OldBuzz/Speedometer-Corrector-Arduino-based/Photos/Cable_01.jpg

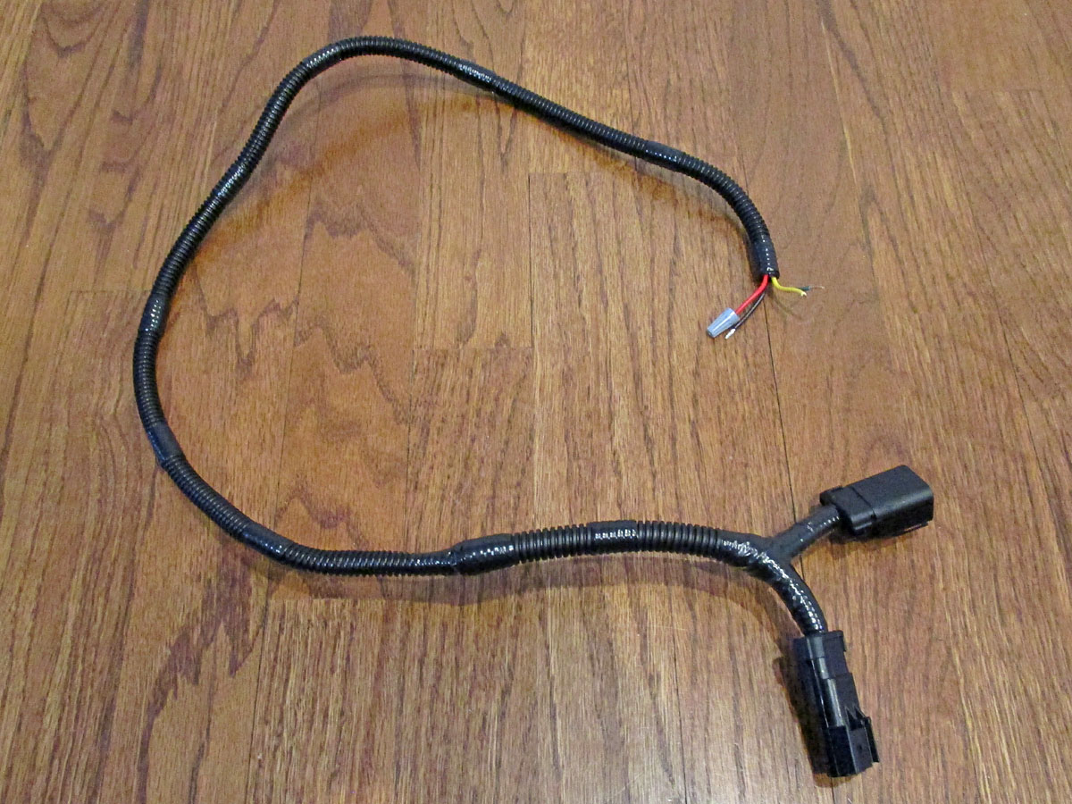
Photos/Cable_01.jpg
