OldBuzz/Speedometer-Corrector-Arduino-based/Photos/Board_02.jpg

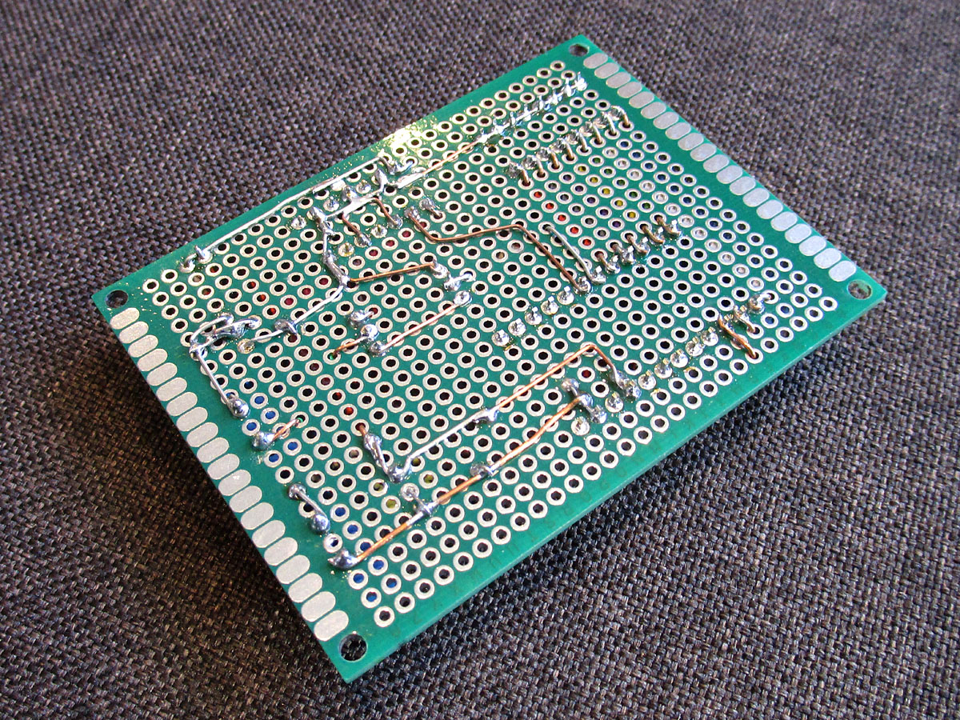
Photos/Board_02.jpg
