OldBuzz/Speedometer-Corrector-Arduino-based/Jeep/Speedo_Corrector_Cable.gif

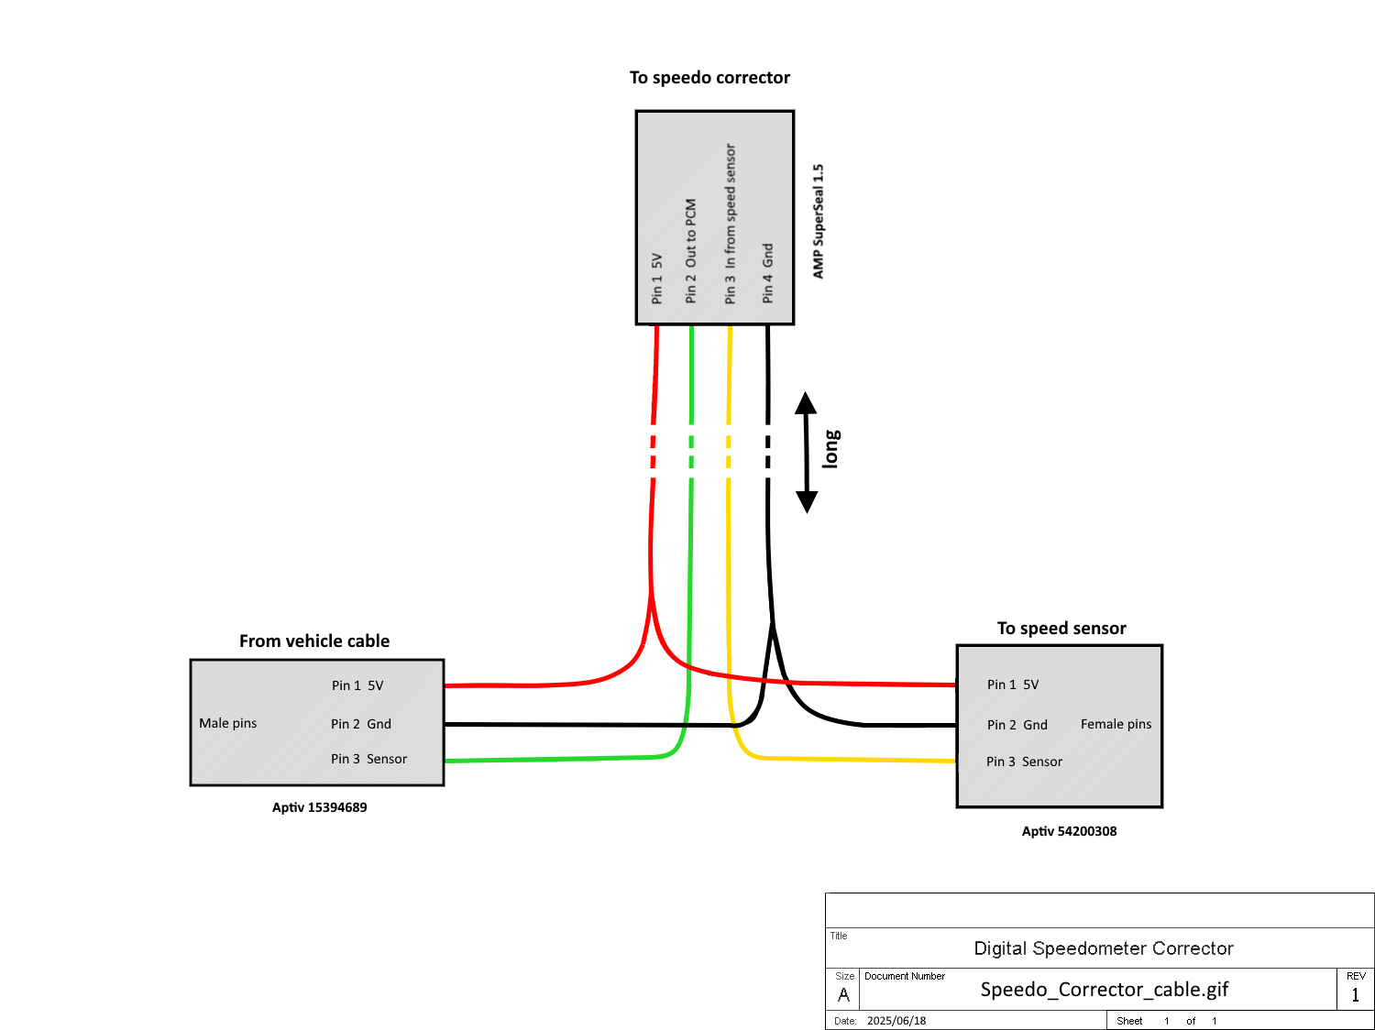
Jeep/Speedo_Corrector_Cable.gif
