OldBuzz/Speedometer-Corrector-Arduino-based/Jeep/Speedo_Sensor_Wires.gif

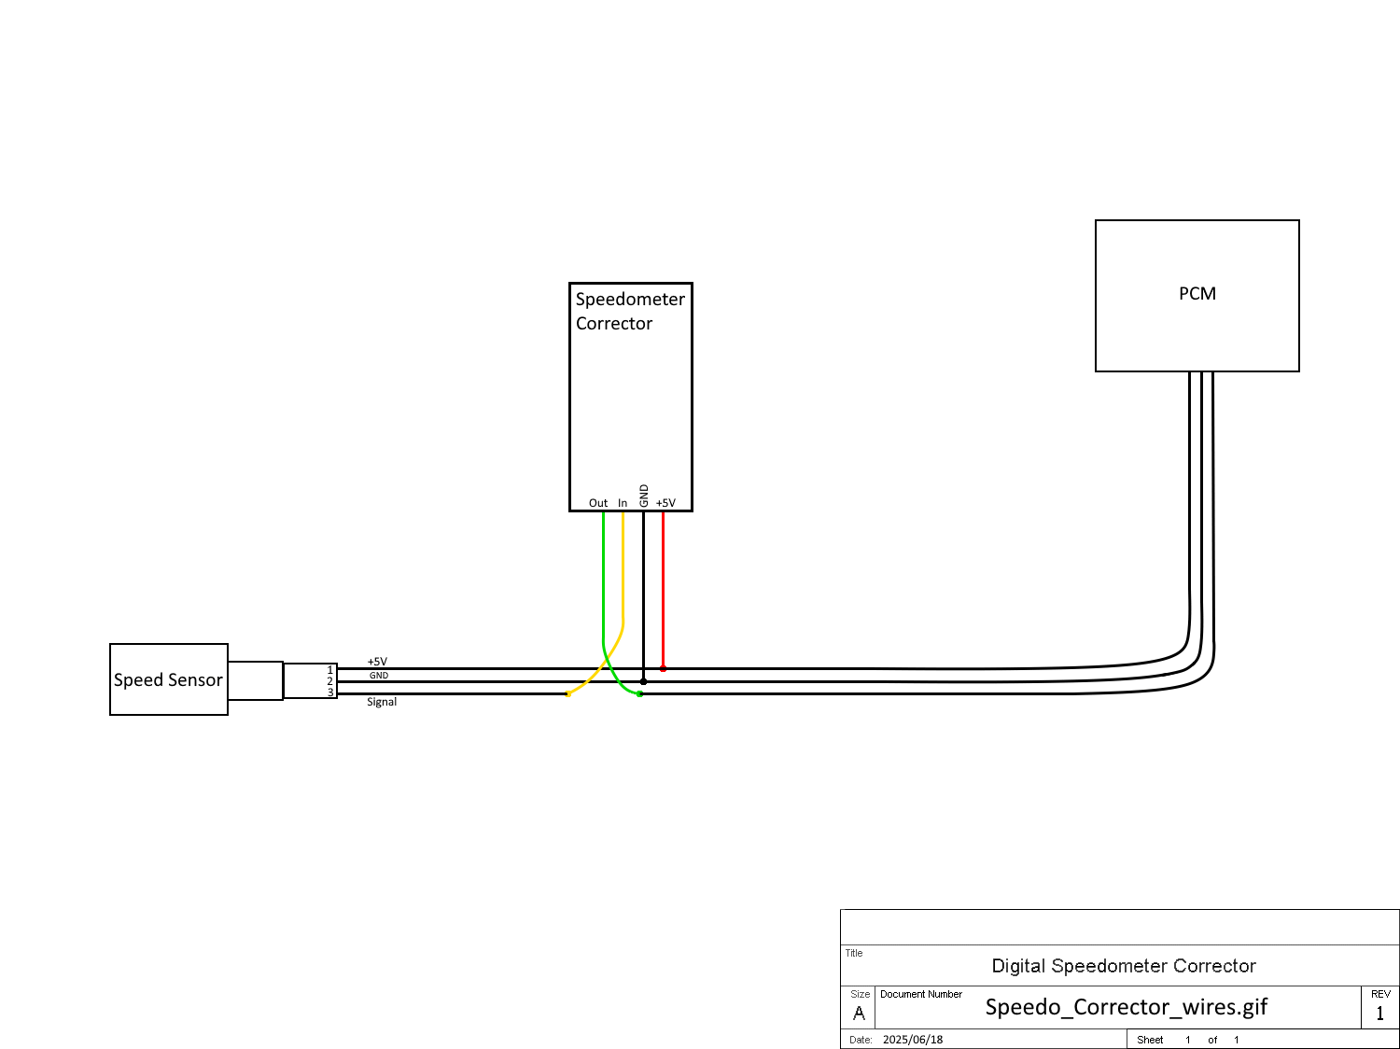
Jeep/Speedo_Sensor_Wires.gif
