OldBuzz/Speedometer-Corrector-Arduino-based/Photos/Board_01.jpg

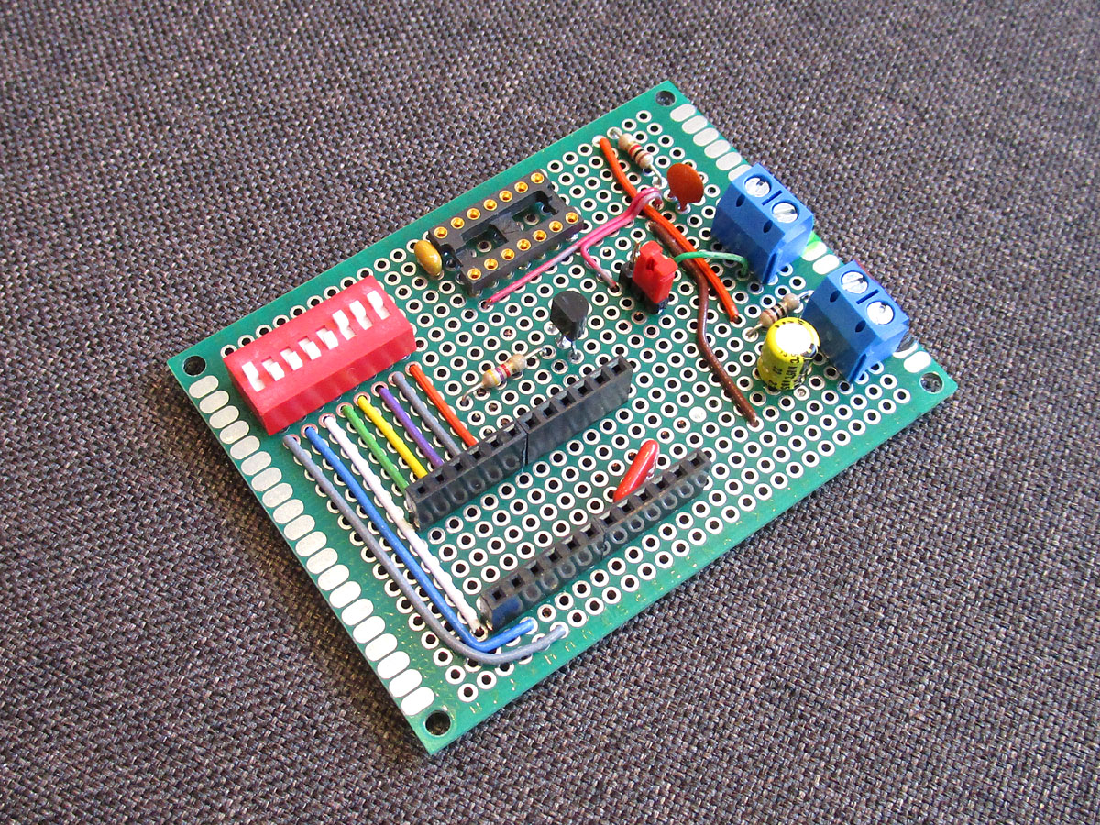
Photos/Board_01.jpg
