OldBuzz/Speedometer-Corrector-Arduino-based/Photos/Board_03.jpg

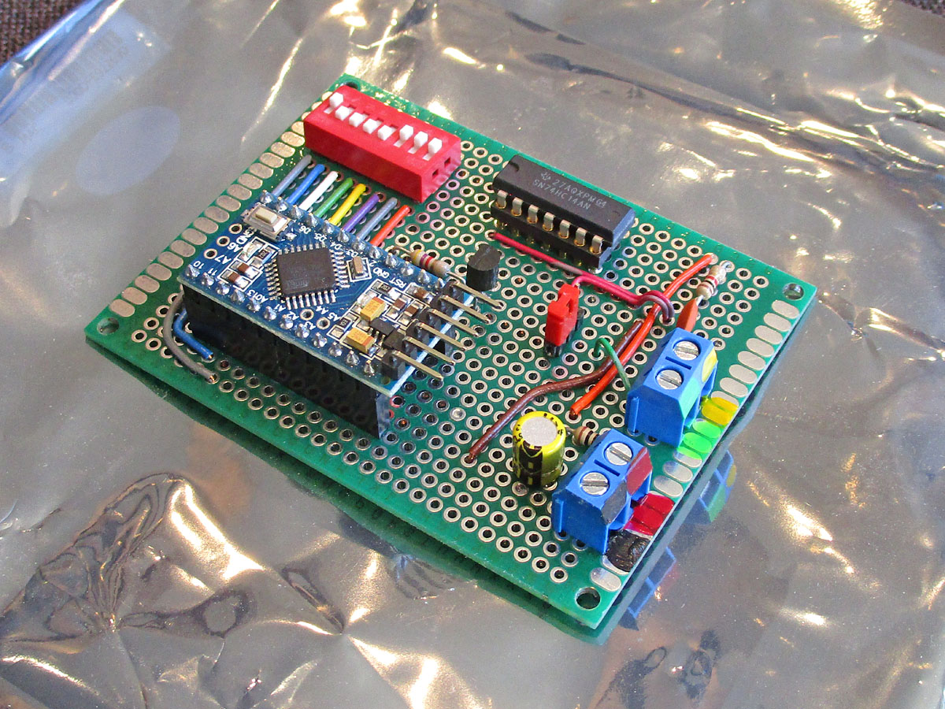
Photos/Board_03.jpg
