OldBuzz/Speedometer-Corrector-Arduino-based/Photos/Board_04.jpg

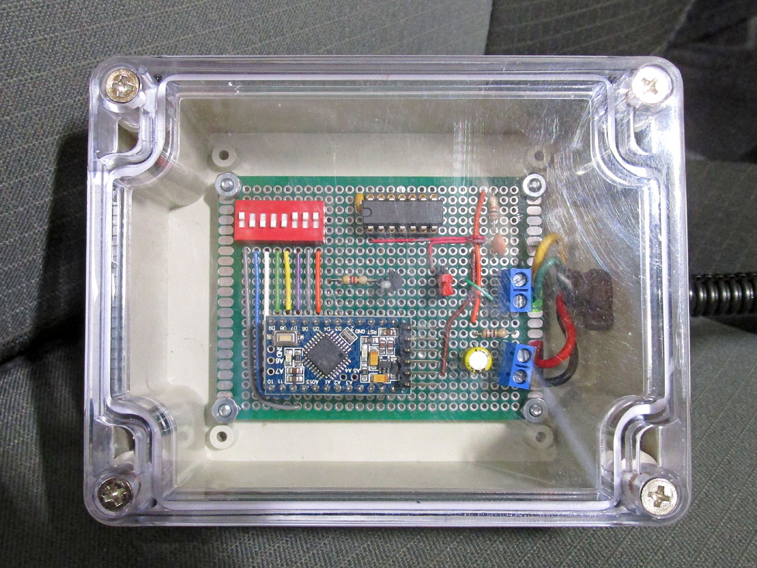
Photos/Board_04.jpg
