OldBuzz/Speedometer-Corrector-Arduino-based/Photos/Board_05.jpg

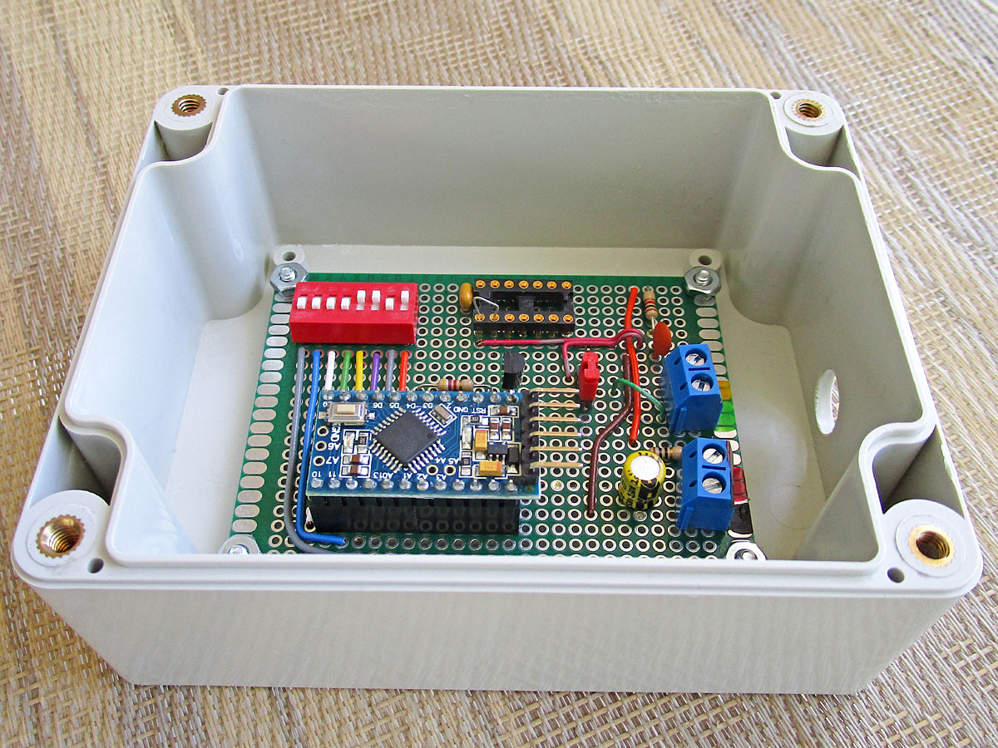
Photos/Board_05.jpg
