OldBuzz/Speedometer-Corrector-Arduino-based/Schematic/Speedo_Corrector_schematic_v2.2.gif

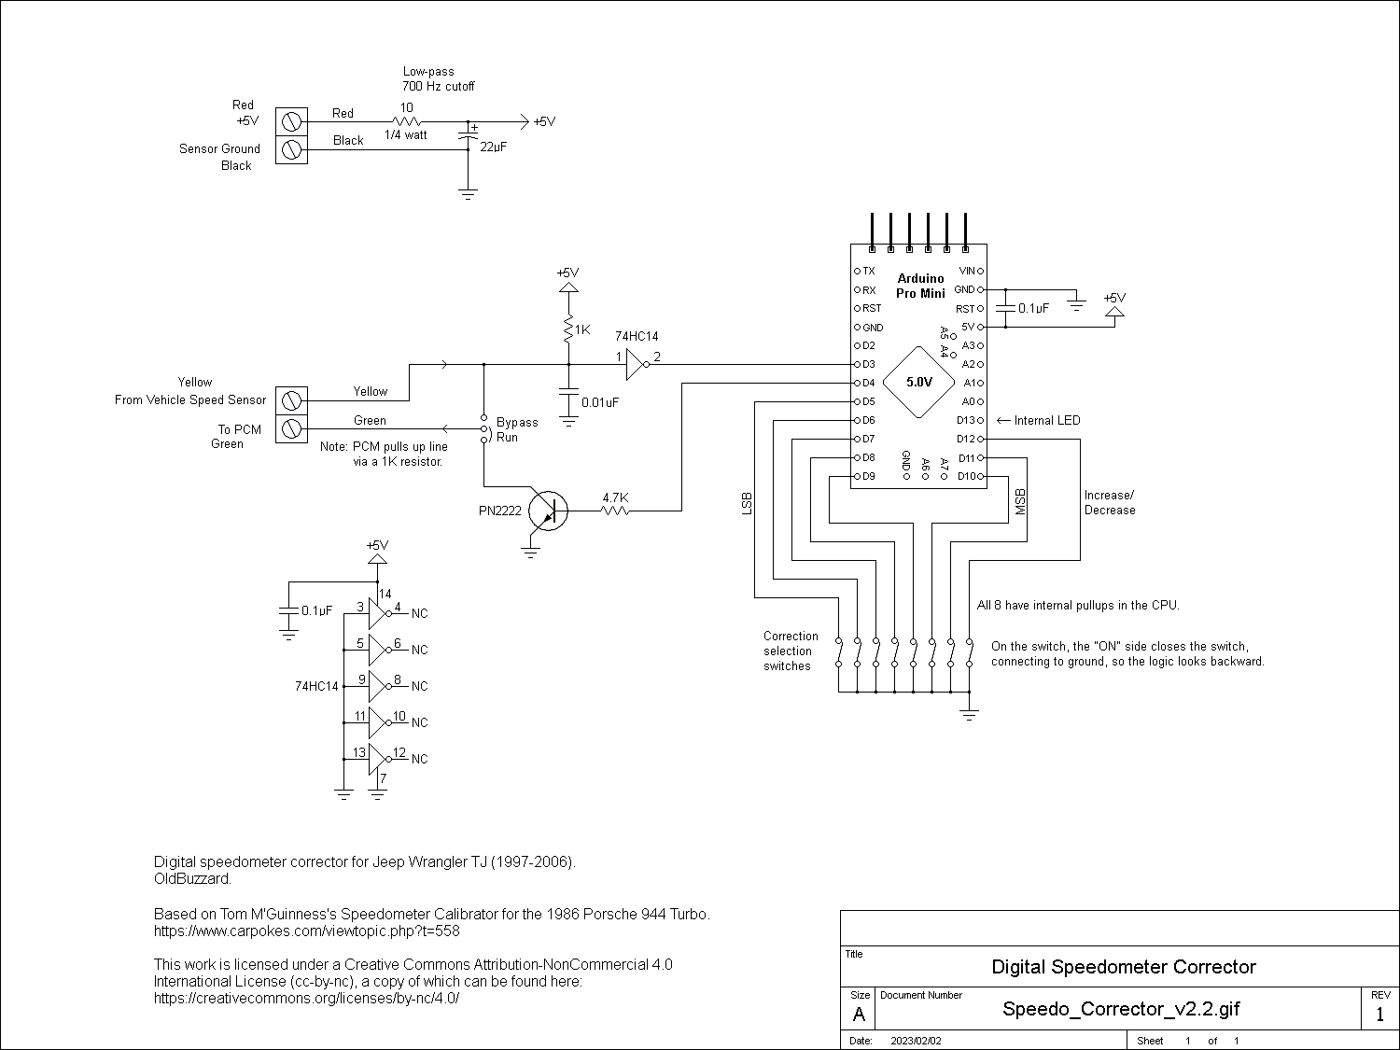
Schematic/Speedo_Corrector_schematic_v2.2.gif
