OldBuzz/Speedometer-Corrector-Arduino-based/Schematic/Speedo_Corrector_schematic_v2.2_KiCad.png

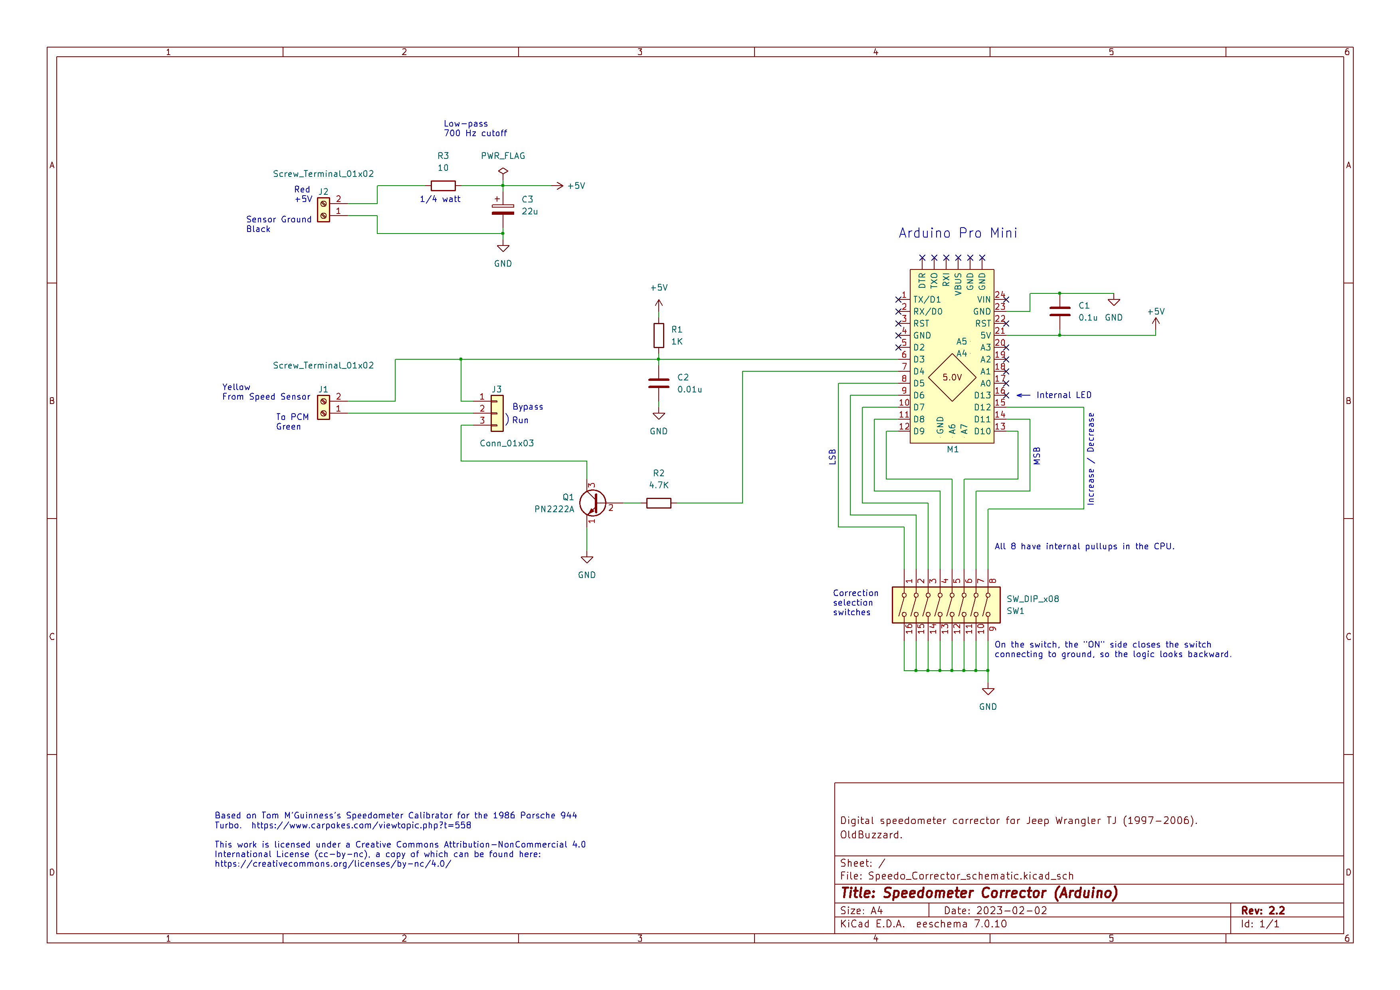
Schematic/Speedo_Corrector_schematic_v2.2_KiCad.png
